W3PM/W3PM-Nano-33-IOT-Universal-MEPT/(threads)

Thread 1 (2023-03-25):

GPS version: wrong frequency

pinozgit, 2023-03-25:
The GPS version does not produce the right frequency.
It is due to the 1pps interrupt subroutine.
Replacing it with the RTC version, the program works just fine.
73
Pino ZP4KFX
