W3PM/W3PM-Nano-33-IOT-Universal-MEPT/K4CLE_board_schematic.pdf

54819-0513

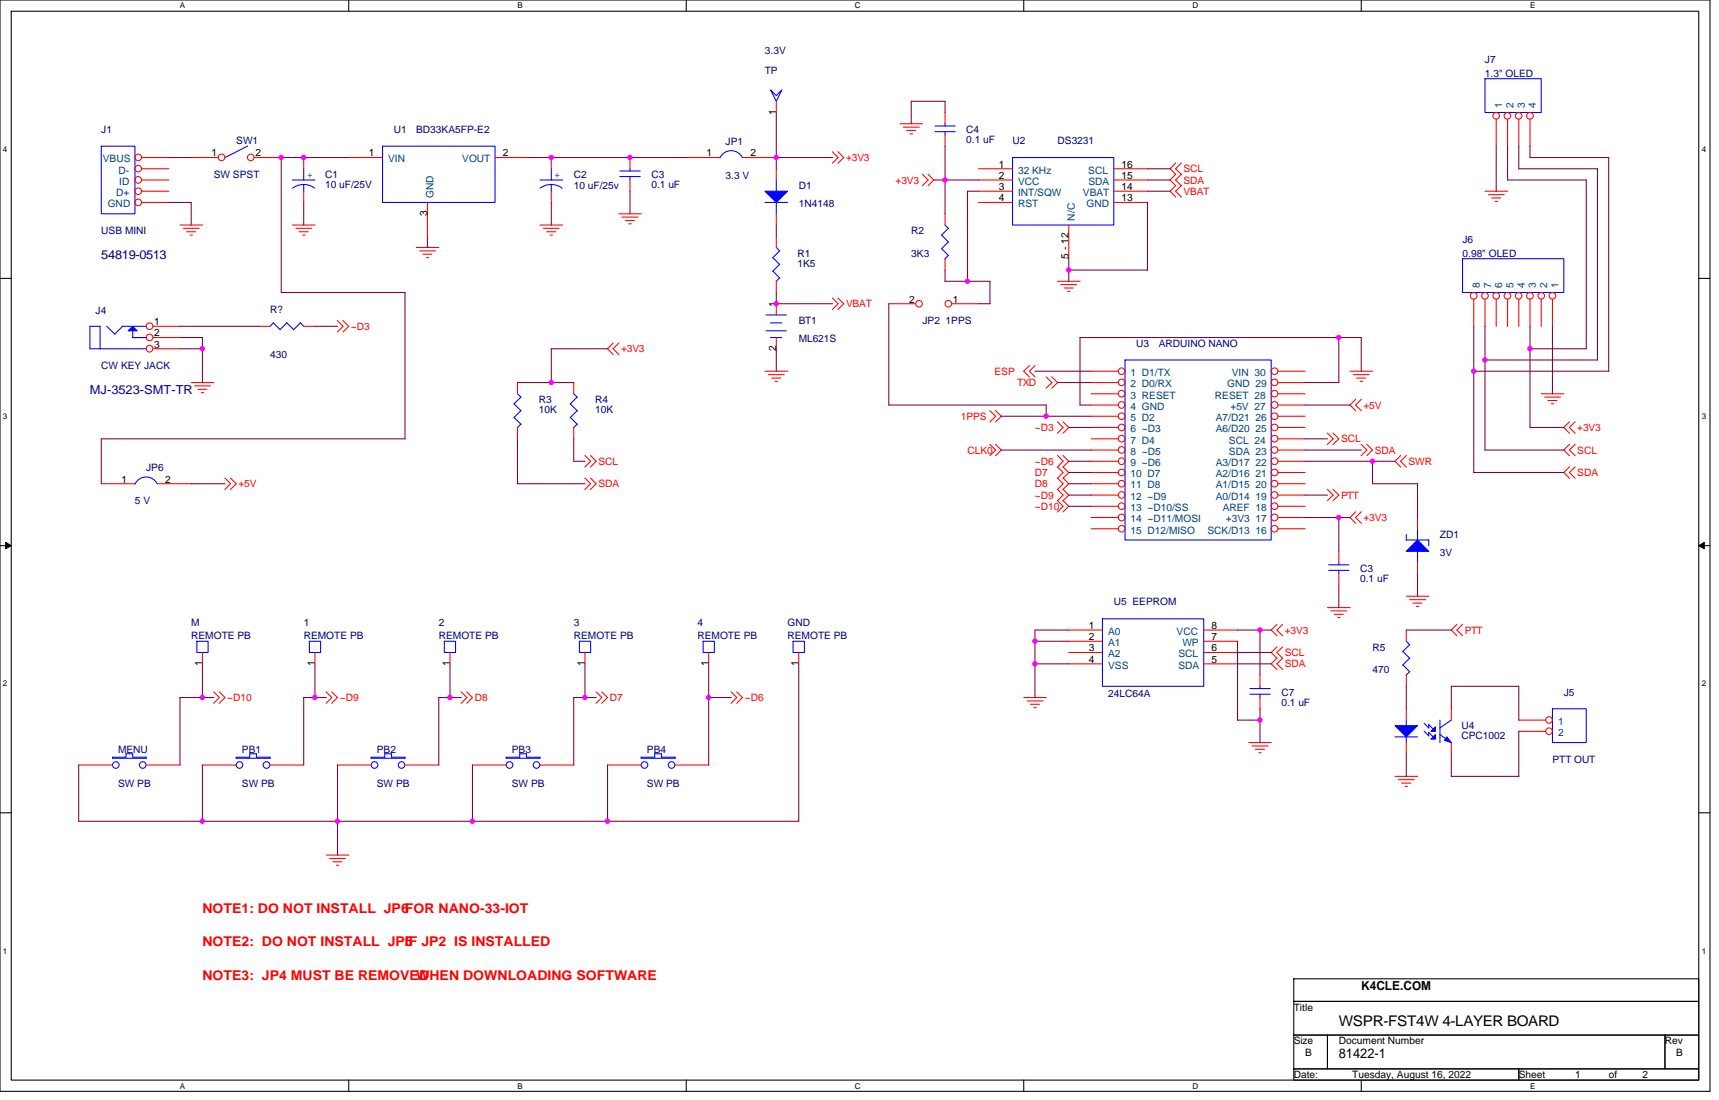
[picture p6: page 1]

NOTE1: DO NOT INSTALL JP6FOR NANO-33-IOT

NOTE2: DO NOT INSTALL JP5IF JP2 IS INSTALLED

NOTE3: JP4 MUST BE REMOVEDWHEN DOWNLOADING SOFTWARE

## RA_BNC

J2

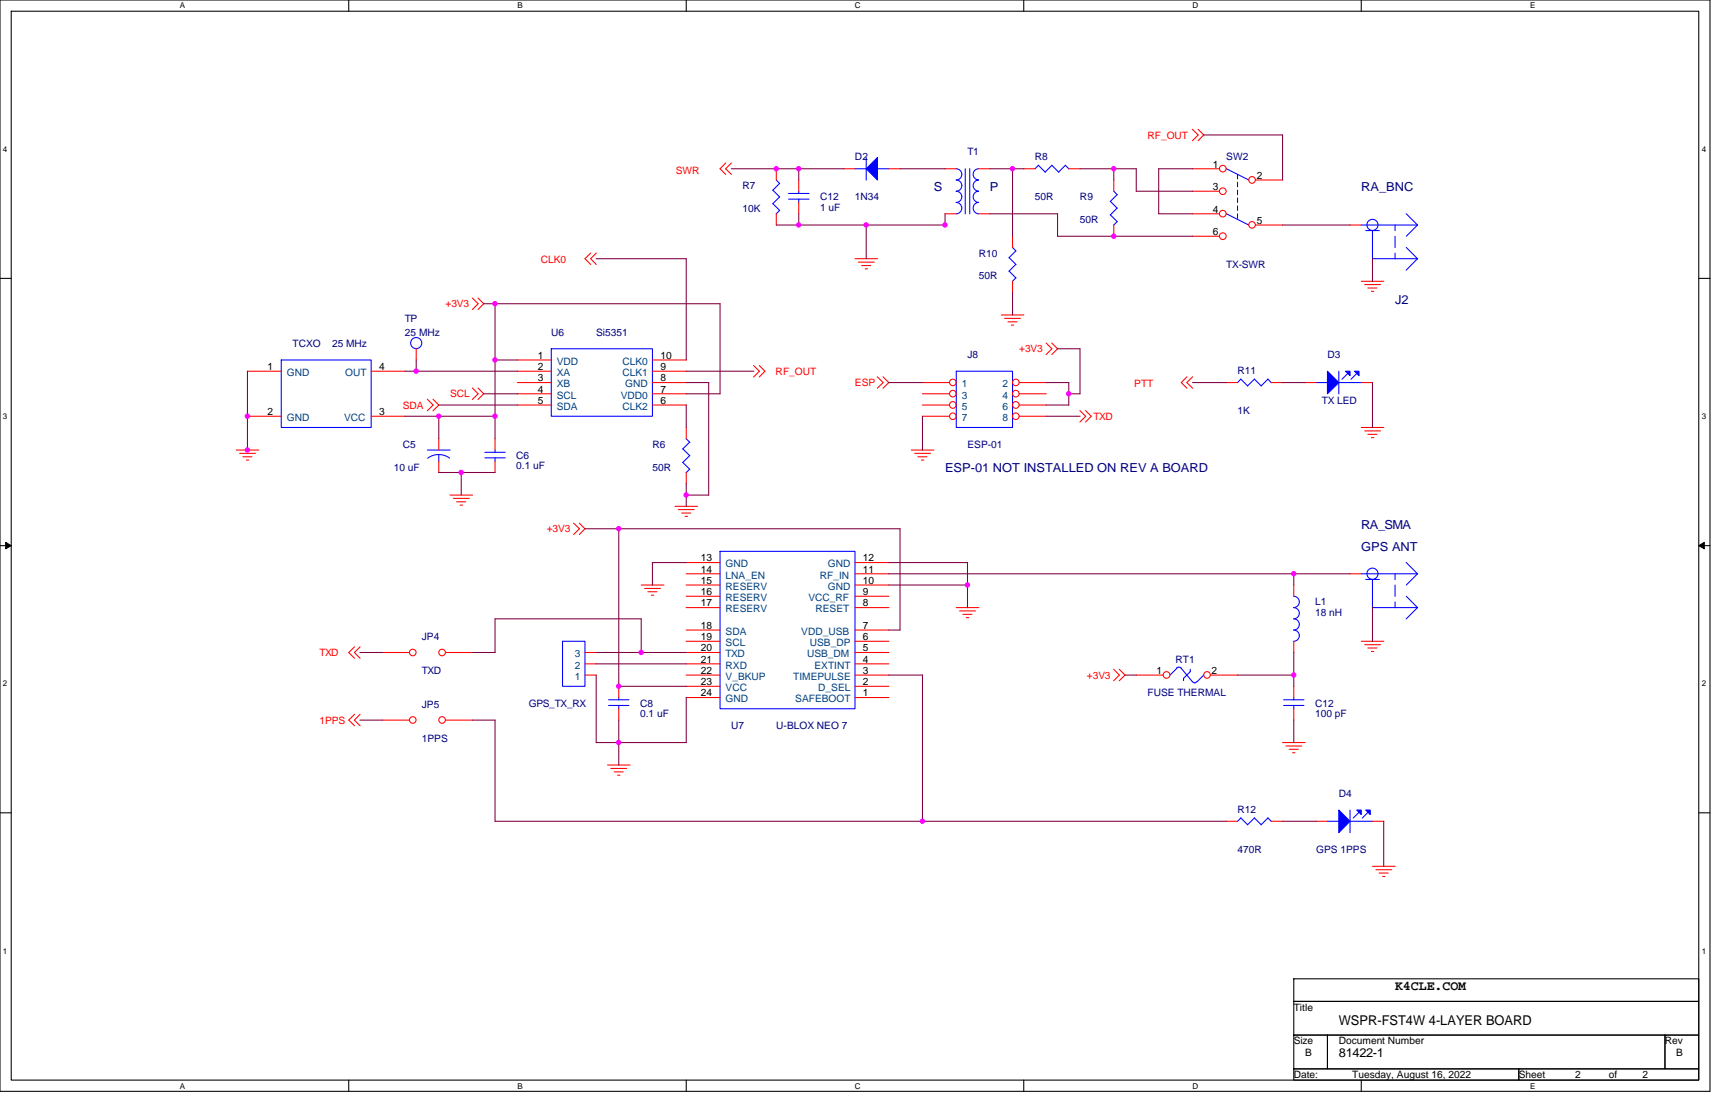
[picture p7: page 2]

ESP-01
ESP-01 NOT INSTALLED ON REV A BOARD
